noqworks/gloam/hardware/step/controller-assembly.step

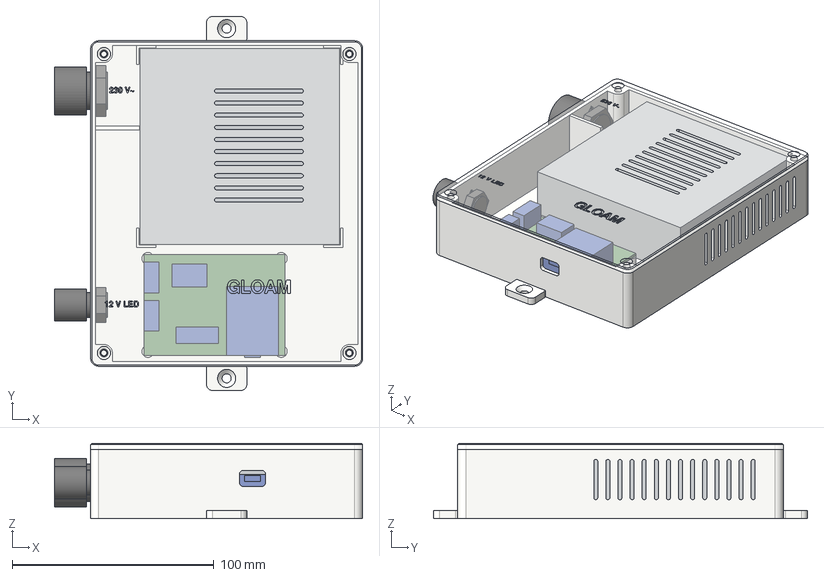
[picture p5: CAD file, 2026-11-10]
hardware/step/controller-assembly.step
152.8 x 185.3 x 37.4 mm
lid
psu
perfboard
d1-mini
uln2003a
step-down
terminal-led
terminal-power
usb-connector
gland-mains
gland-led
