noqworks/gloam/hardware/3mf/gloam-a1.3mf

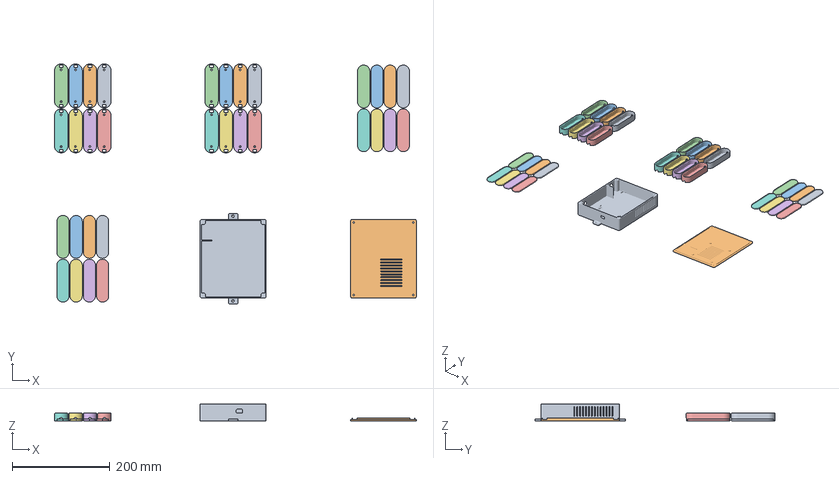
[picture p6: CAD file, 2026-11-10]
hardware/3mf/gloam-a1.3mf
739.6 x 490.7 x 34.4 mm
fixture-body_1 x 2
fixture-body_2 x 2
fixture-body_3 x 2
fixture-body_4 x 2
fixture-body_5 x 2
fixture-body_6 x 2
fixture-body_7 x 2
fixture-body_8 x 2
fixture-diffuser_1 x 2
fixture-diffuser_2 x 2
fixture-diffuser_3 x 2
fixture-diffuser_4 x 2
fixture-diffuser_5 x 2
fixture-diffuser_6 x 2
fixture-diffuser_7 x 2
fixture-diffuser_8 x 2
controller-box_1
controller-lid_1
