noqworks/gloam/hardware/step/controller-lid.step

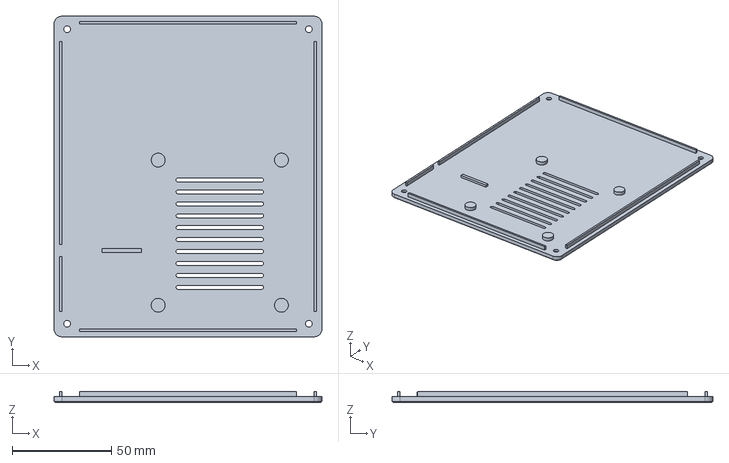
[picture p7: CAD file, 2026-11-10]
hardware/step/controller-lid.step
134.8 x 161.3 x 5.50 mm
