noqworks/gloam/hardware/step/controller-box.step

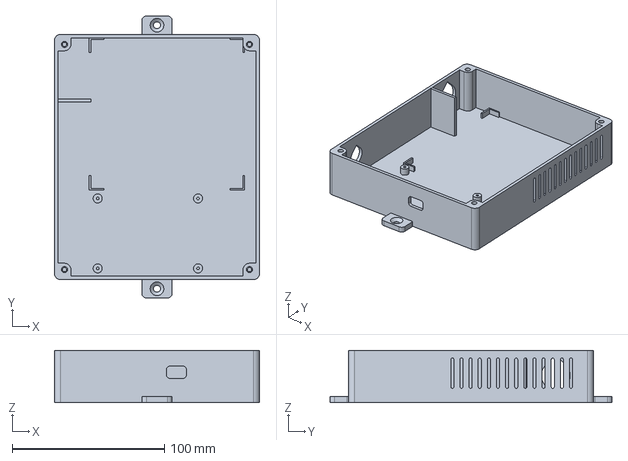
[picture p8: CAD file, 2026-11-10]
hardware/step/controller-box.step
134.8 x 185.3 x 34.4 mm
