noqworks/gloam/hardware/step/fixture-diffuser.step

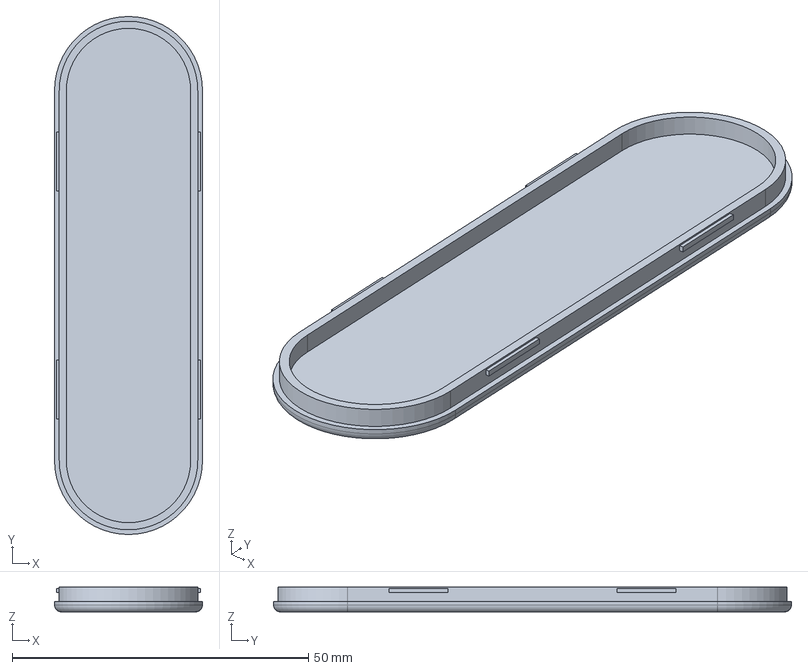
[picture p9: CAD file, 2026-11-03]
hardware/step/fixture-diffuser.step
25.0 x 87.5 x 4.20 mm
