noqworks/gloam/hardware/step/fixture-body.step

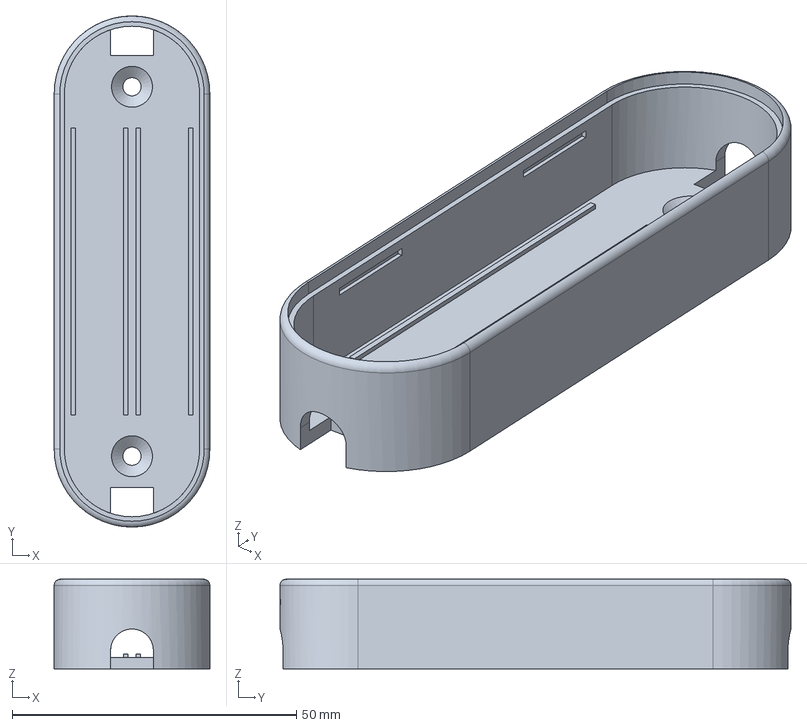
[picture p10: CAD file, 2026-11-03]
hardware/step/fixture-body.step
27.4 x 89.9 x 15.8 mm
