noqworks/gloam/(list of files, cad)

Other CAD files:
hardware/stl/controller-box.stl
hardware/stl/controller-lid.stl
hardware/stl/fixture-body.stl
hardware/stl/fixture-diffuser.stl
