noqworks/gloam/(commit log)

2026-11-02 Gloam 1.0.0
    [controller-box.stl, controller-inner-plate.stl, controller-lid.stl, fixture-body.stl, fixture-diffuser.stl]
2026-11-03 Gloam 1.1.0
    [controller-assembly.step, controller-box.step, controller-box.stl, controller-inner-plate.stl, controller-lid.step, controller-lid.stl, fixture-body.step, fixture-body.stl]
2026-11-03 Gloam 1.2.0
    Works without Home Assistant: the device serves its own control page on the home
    network (lights, effects, daily schedule, power-on behaviour), a wall switch lights
    the last scene and the schedule runs on the device. Home Assistant stays optional
    and works at the same time.
    Settings added in this release are set up after Wi-Fi, so an update from 1.1.0
    keeps the saved home network.
2026-11-03 Gloam 1.2.1
    The control page can live on the phone's home screen: NOQ Open icon, the device's
    name, full screen. On first visit it shows, for the phone in hand, how to add it.
2026-11-10 Add Bambu Studio print projects for the A1
    Sliced 3MF projects in hardware/3mf: fixture bodies and diffusers on four plates, controller box and lid on two. Bambu Lab A1, 0.4 mm nozzle, PETG, 0.2 mm layers, no supports.
    [gloam-controller-a1.3mf, gloam-fixture-a1.3mf]
2026-11-10 One print project for the whole set; wider USB slot
    hardware/3mf/gloam-a1.3mf replaces the two separate projects: 16 bodies, 16 diffusers, the controller box and its lid on six plates. The USB slot in the controller box is 13 x 8 mm so USB-C plug bodies fit as well as micro-USB. The fixture screw size is in the CAD notes.
    [controller-assembly.step, controller-box.step, controller-box.stl, controller-lid.step, gloam-a1.3mf, gloam-controller-a1.3mf, gloam-fixture-a1.3mf]
2026-11-10 Parametric controller box: your own power supply, perfboard and an extra module
    gloam_controller.py takes --set / --json parameters (psu_x, psu_y, psu_h, psu_divider, board_x, board_y,
    extra_x, extra_y, extra_h); walls, glands, divider, screw columns, lid pads and vents follow. The defaults
    give the same box as before. --params lists the parameters, --report writes the layout and the fit check.
